scottljw/VincentTheRobot_02-04-02/README.md

# Vincent the Robot (to Rescue)

__Status of Progress:__

This project is finished.

----------

- __*Useful Sources：*__
  - [Arduino Uno Rev3 Schematic](https://www.arduino.cc/en/uploads/Main/Arduino_Uno_Rev3-schematic.pdf)
  - [Arduino programming language, Language Reference](https://www.arduino.cc/reference/en/)
  - [Raspberry Pi Downloads]( https://www.raspberrypi.org/downloads/)
  - [How does LiDAR work?](http://www.lidar-uk.com/how-lidar-works/)
  - [Basics of USART Communication](http://www.circuitbasics.com/basics-uart-communication/)
  - [Atmega328p Datasheet](Datasheets/ATmega328-328P_Datasheet.pdf)
  - [Atmega328p Pin Mapping](Datasheets/Atmega328pPinMap.png)
  - [LIDAR Datasheet](Datasheets/LD108_SLAMTEC_rplidar_datasheet_A1M8_v1.0_en.pdf)
  - [Autonomous Search](Datasheets/autonomous%20systems%20for%20search%20and%20rescue.pdf)
  - [SLAM](Datasheets/1aslam_blas_repo.pdf)
