scottljw/VincentTheRobot_02-04-02/Report & Presentation/System Architecture.pptx

<<device>>
:Motor

<<device>>
:Arduino

Motor Control

Sound Detection

PWM

<<device>>
:Ultrasonic Sensor

Trigger

Period
