scottljw/VincentTheRobot_02-04-02/Budget/Sample_Receipts.pdf

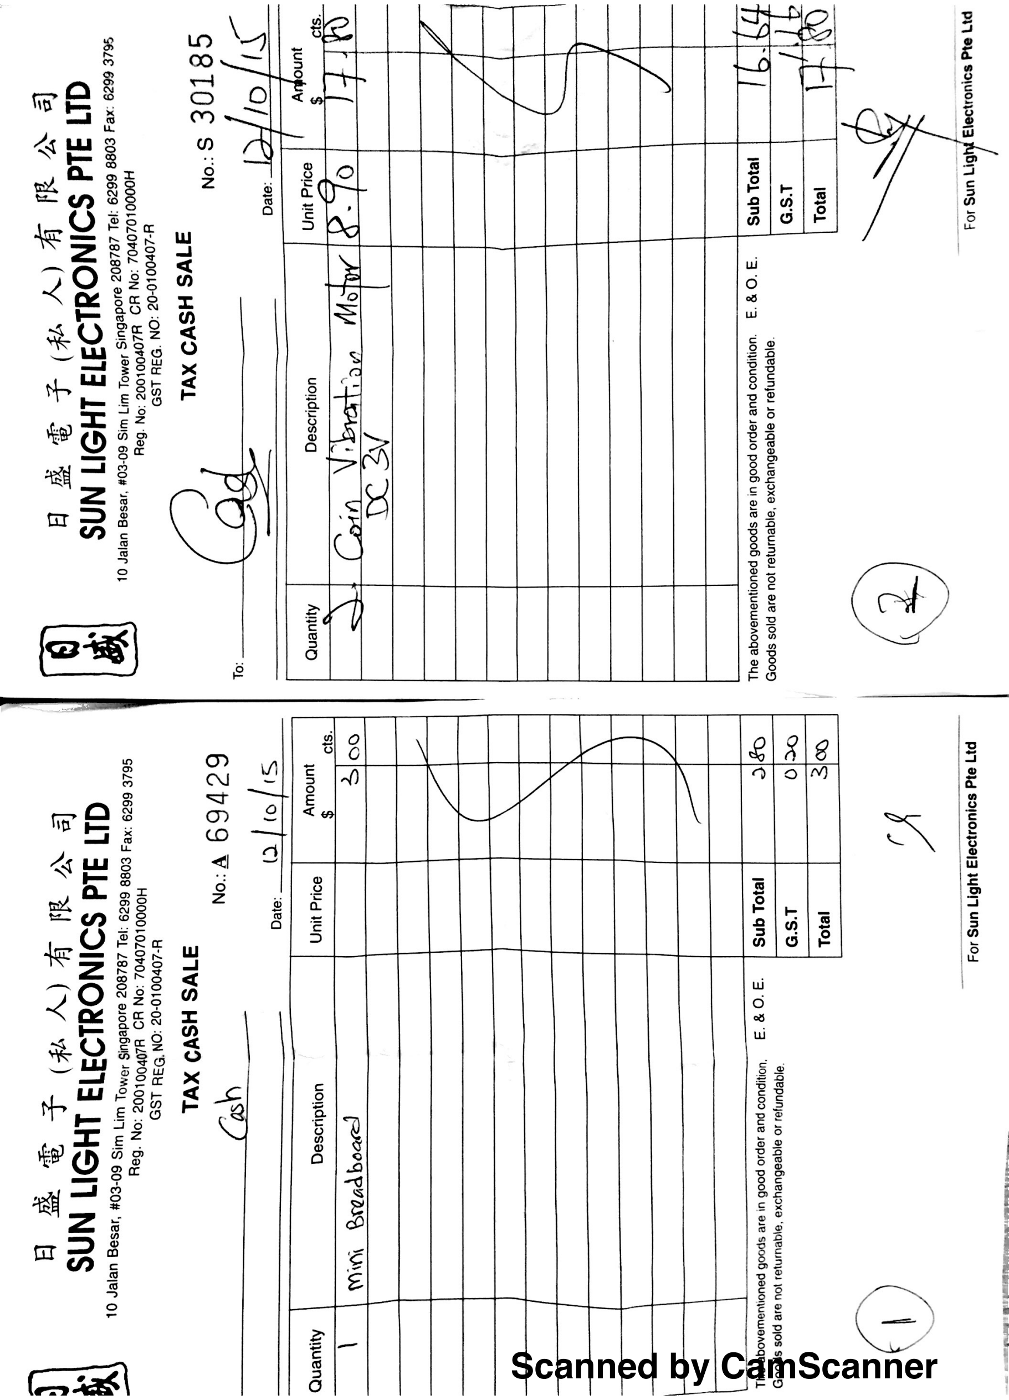
[picture p5: page 1]

Scanned by CamScanner

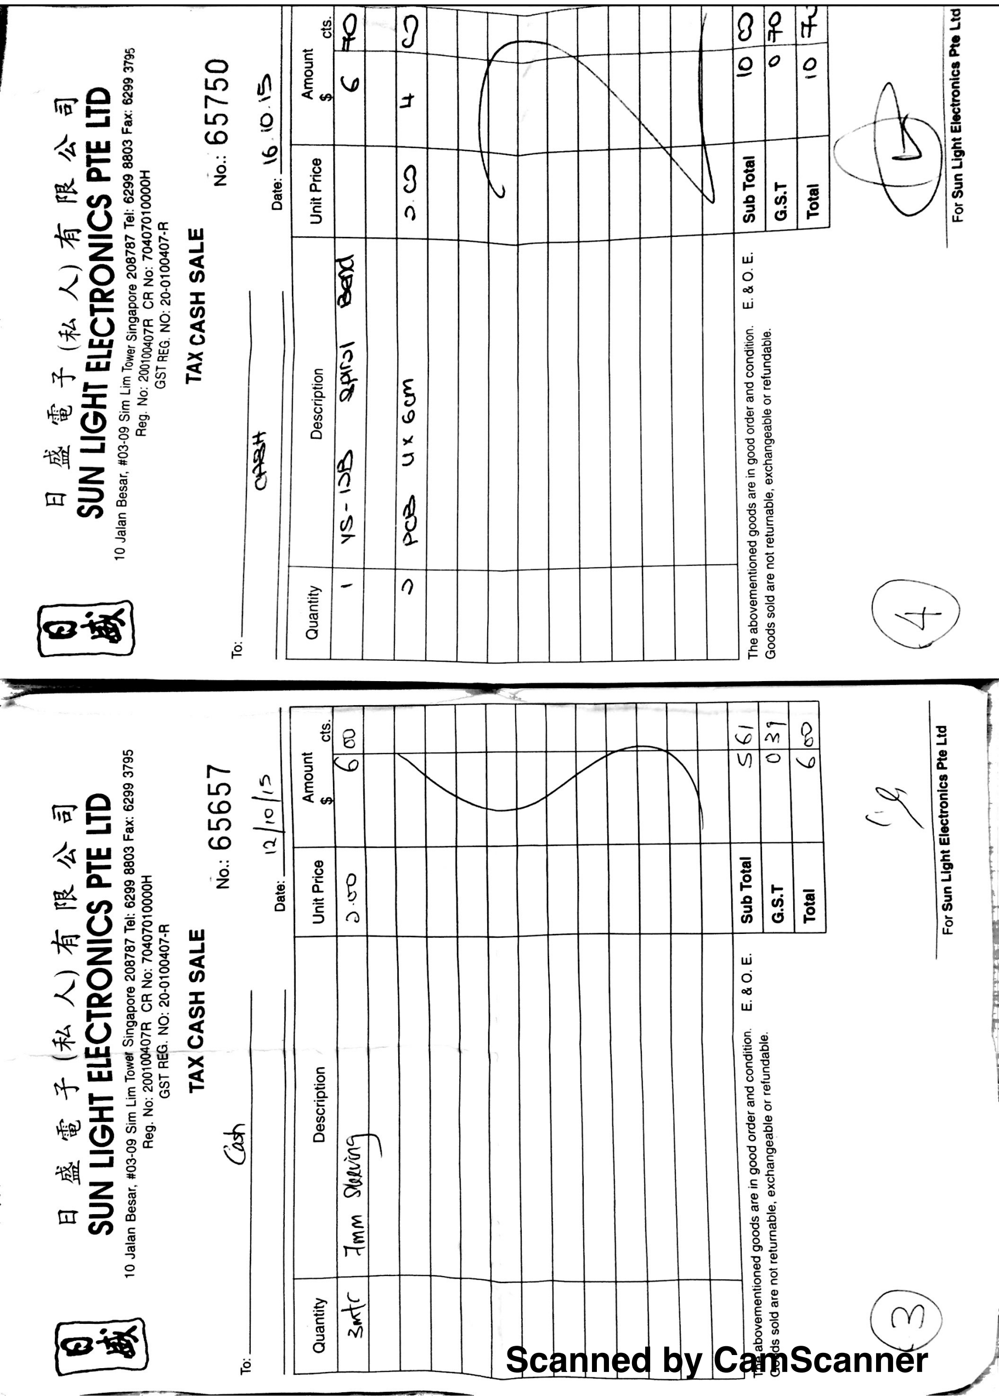
[picture p6: page 2]
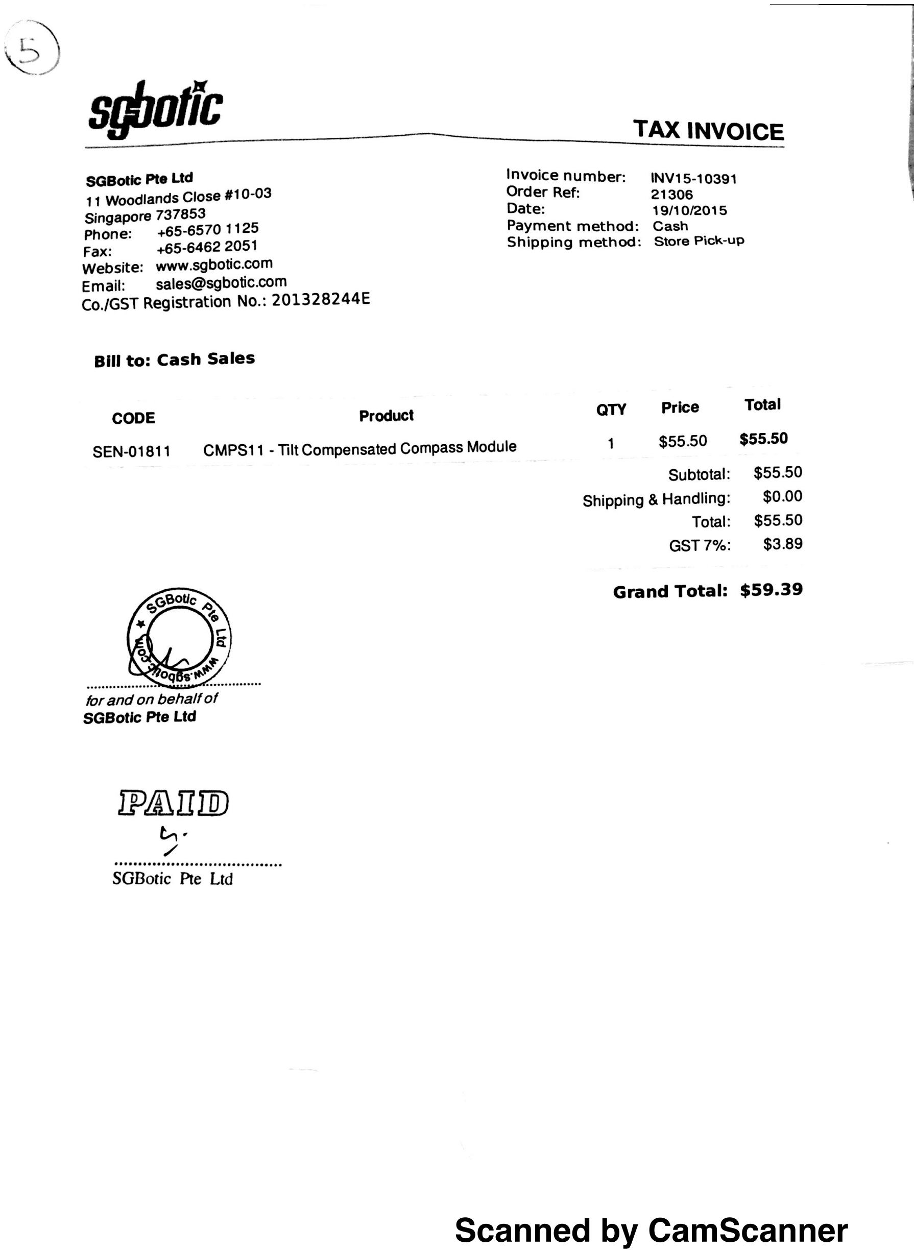
[picture p7: page 3]
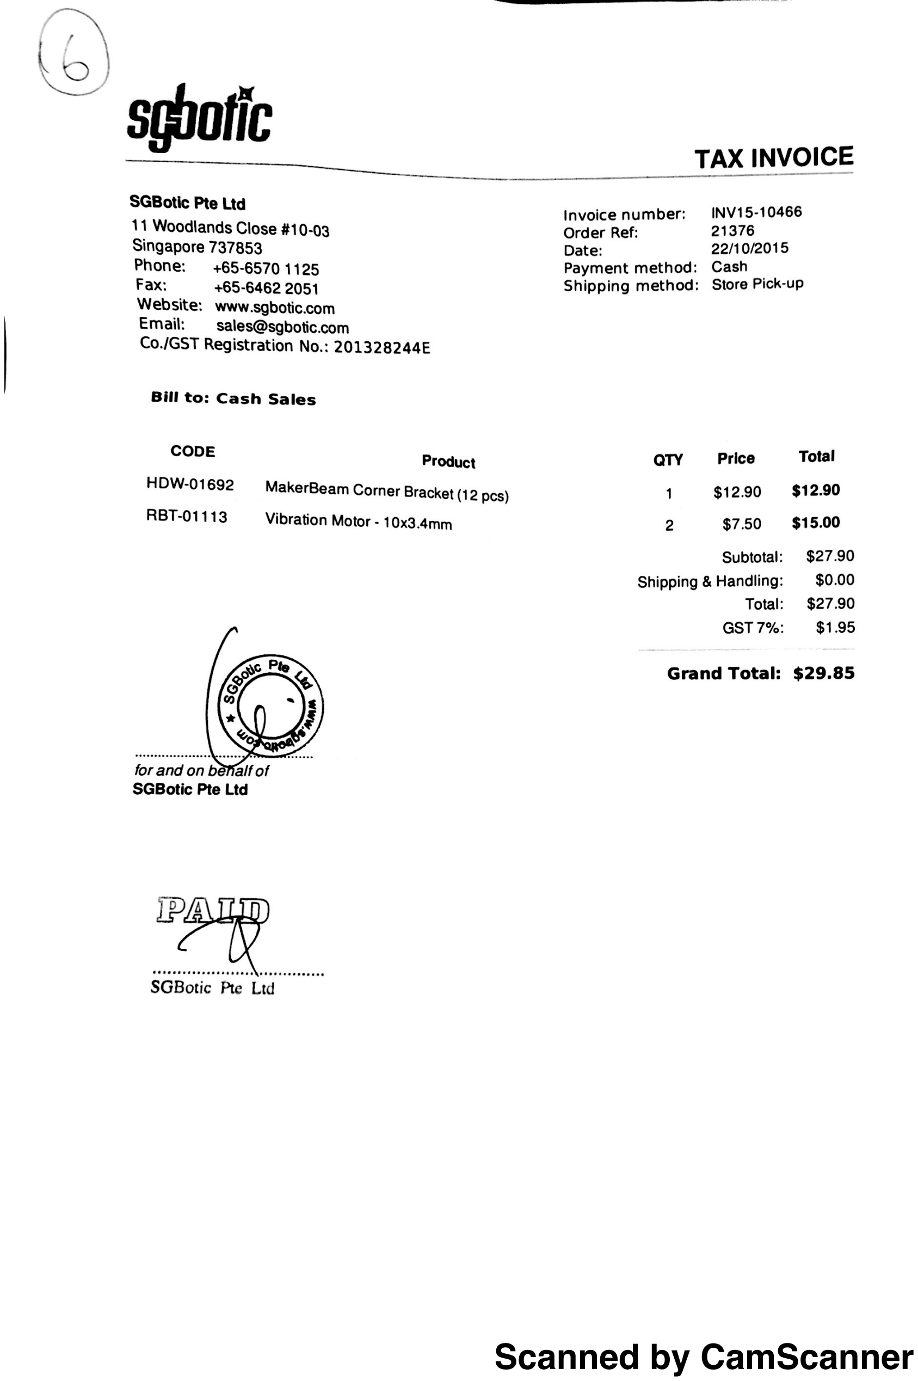
[picture p8: page 4]
