scottljw/VincentTheRobot_02-04-02/Report & Presentation/System Architecture.png

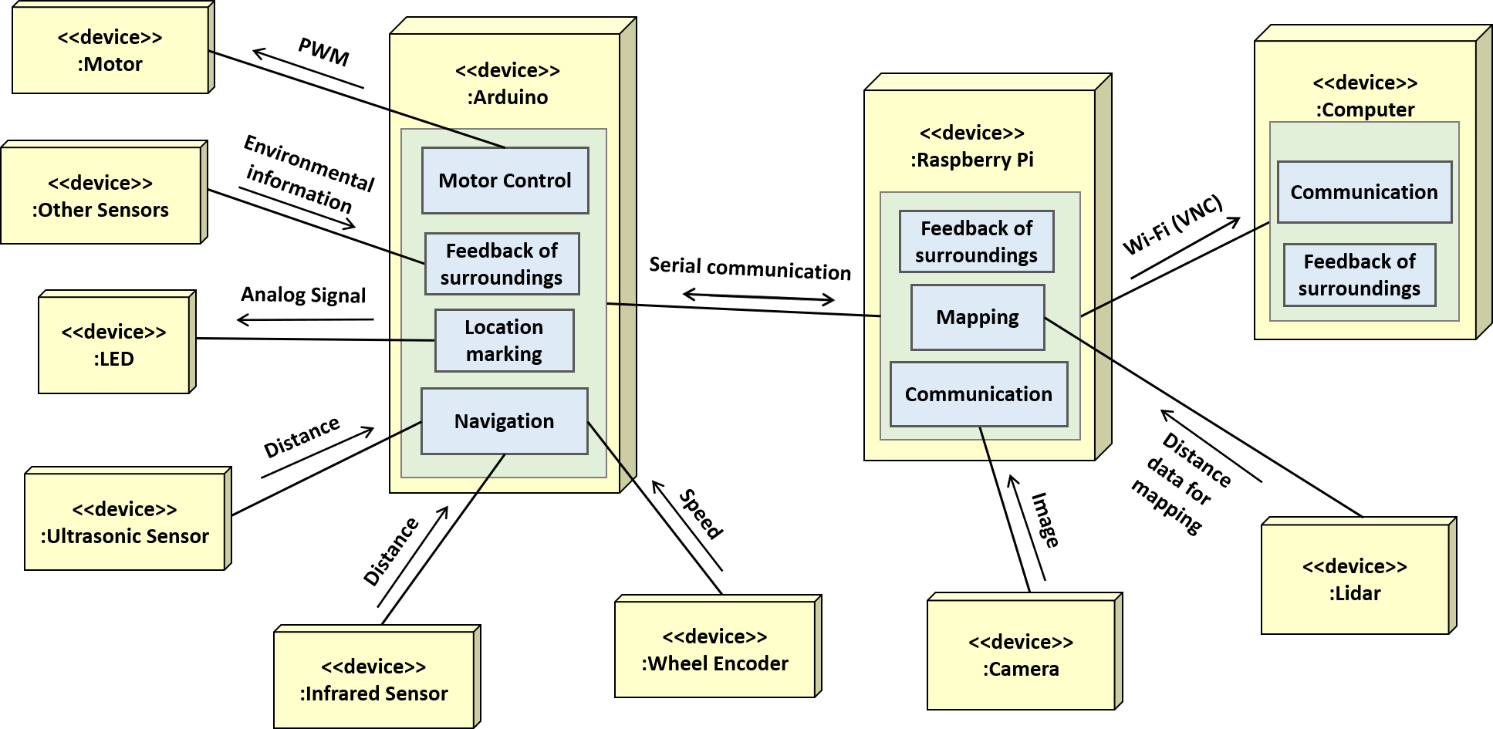
Report & Presentation/System Architecture.png
