scottljw/VincentTheRobot_02-04-02/Budget/List of expenses - Template.xlsx

List of expenses
S/N | Date | Vendor Name | Brief Description | GST Code | Foreign currency amount | Currency Rate | Amount (S$) | GL
1 | 2015-04-01 | Sample One | Some sensors | I7 |  |  | $11.20
2 | 2015-04-01 | Oversea Sample Two | Some other sensors | IE | 36.5 | 0.2 | $7.30
 |  |  | Total |  |  |  | $18.50
