scottljw/VincentTheRobot_02-04-02/(commit log)

2018-03-20 Budget related
    [List of expenses - Template.xlsx]
2018-03-21 Pwmval debugged
2018-03-22 Update forwardDist and reverseDist
    [vincent.ino]
2018-03-22 mend “TicksTurns"
2018-04-07 all on arduino now
2018-04-09 Using only one pin
2018-04-09 changed RR pin from 11 to 9
2018-04-13 pressure and temperature sensor I2c works
2018-04-13 code to test both Ultrasonic sensors working back to back
2018-04-16 Update vincent_solo.ino
    calibration done. still turns astray at end of motion
2018-04-16 Update vincent_solo.ino
    First draft of integrating IR sensor to avoid bumming into a wall in front
    [vincent_solo.ino]
2018-04-17 added LEDs
2018-04-17 Called LED in comToAr()
2018-04-17 Update Vincent Monday with SD
    back track working??
2018-04-17 corrected LED ports
2018-04-17 working version of blinking LED
